Nocatbin/ProjectAir/ProjectAir_PCB/OUTPUT/BOM.xls

Sheet: BOM Report
Bill of Materials |  |  | Bill of Materials for PCB Document [ProjectAir_Pcb.PcbDoc]
Source Data From: |  | ProjectAir_Pcb.PcbDoc
Project: |  | ProjectAir_Pcb.PrjPcb
Variant: |  | None
Creation Date: | 2020/11/1 | 22:56
Print Date: | 2020-11-02 | 19:19:54
Footprint | Comment | LibRef | Designator | Description | Quantity
BAT_RTC | BATT | BAT | BAT1 |  | 1
MAINBAT | MAINBATTARY | MAINBAT | BAT2 | MAINBATTARY | 1
C Pol | Cap Pol3 | Cap Pol3 | C1, C2 | Polarized Capacitor (Surface Mount) | 2
0805 | 104 | C | C3, C4, C5, C7, C12, C13 |  | 6
0805 | 10uF | C, C_2 | C6, C14, C15 |  | 3
0805 | 10 | C | C8, C9 |  | 2
0805 | 22 | C | C10, C11 |  | 2
SOD-123 | 1N4148 | D | D1, D2 |  | 2
0805D | LED BLUE | LED2 | DS1, DS4 | Typical RED, GREEN, YELLOW, AMBER GaAs LED | 2
0805D | LED GREEN | LED2 | DS2 | Typical RED, GREEN, YELLOW, AMBER GaAs LED | 1
0805D | LED RED | LED2 | DS3 | Typical RED, GREEN, YELLOW, AMBER GaAs LED | 1
M2孔 | HOLE | M2孔 | H1, H2, H3, H4 | M2孔 | 4 | /
1*3PIN | 1*3P排针 | 1*3P排针 | J1 | 1*3P排针 | 1
1*4Pin | 1*4P排母 | 1*4P排母 | J2, J3 | 排母 | 2
PWR SWITCH | PWR SWITCH | PWR SWITCH | K1 | PWR SWITCH | 1
0805R | 0R | R | R1, R2 |  | 2
0805R | 10R | R | R3 |  | 1
0805R | 10K | R | R4, R5, R7 |  | 3
0805R | 1M | R | R6 |  | 1
0805R | 1.2K | R_1 | R8 |  | 1
0805R | 1K | R_1 | R9, R10 |  | 2
PTC | PTC 1A | PTC保险 | R11 | PTC 1A | 1
SMD | KEY_M | KEY_M | RESET |  | 1
SOT23-3 | SC662K-3.3V | SC662K-3.3V | U1 | SCK662K-3.3V | 1
STM32F103C8T6 | STM32F103C8T6 | STM32F103C8T6 | U2 | STM32 ARM-based 32-bit MCU with 64 Kbytes Flash, 48-pin LQFP, Industrial Temperature | 1
ESOP-8 | TC4056A | TC4056A | U3 | 充电芯片 | 1
TYPE-C | TYPE-C | TYPE-C | U4 |  | 1
SMD-5032_2P | 8MHz | XTAL | Y1 | Crystal Oscillator | 1
SMD_1610 | 32.768K | XTAL_1 | Y2 | Crystal Oscillator | 1
 |  |  |  |  | 49
Approved |  | Notes

Sheet: Project Information
Project Full Path | C:\Users\15005\Desktop\ProjectAir\ProjectAir_PCB\ProjectAir_Pcb.PrjPcb
Project Filename | ProjectAir_Pcb.PrjPcb
Variant Name | None
Data-Source Filename | ProjectAir_Pcb.PcbDoc
Data-Source Full Path | C:\Users\15005\Desktop\ProjectAir\ProjectAir_PCB\ProjectAir_Pcb.PcbDoc
Title | Bill of Materials for PCB Document [ProjectAir_Pcb.PcbDoc]
Total Quantity | 49
Report Time | 22:56
Report Date | 2020/11/1
Report Date & Tine | 2020/11/1 22:56
Output Name | Bill of Materials
Output Type | BOM_PartType
Output Generator Name | BOM
Output Generator Description | Bill of Materials
