Nocatbin/ProjectAir/ProjectAir_PCB/ProjectAir_Pcb.pdf

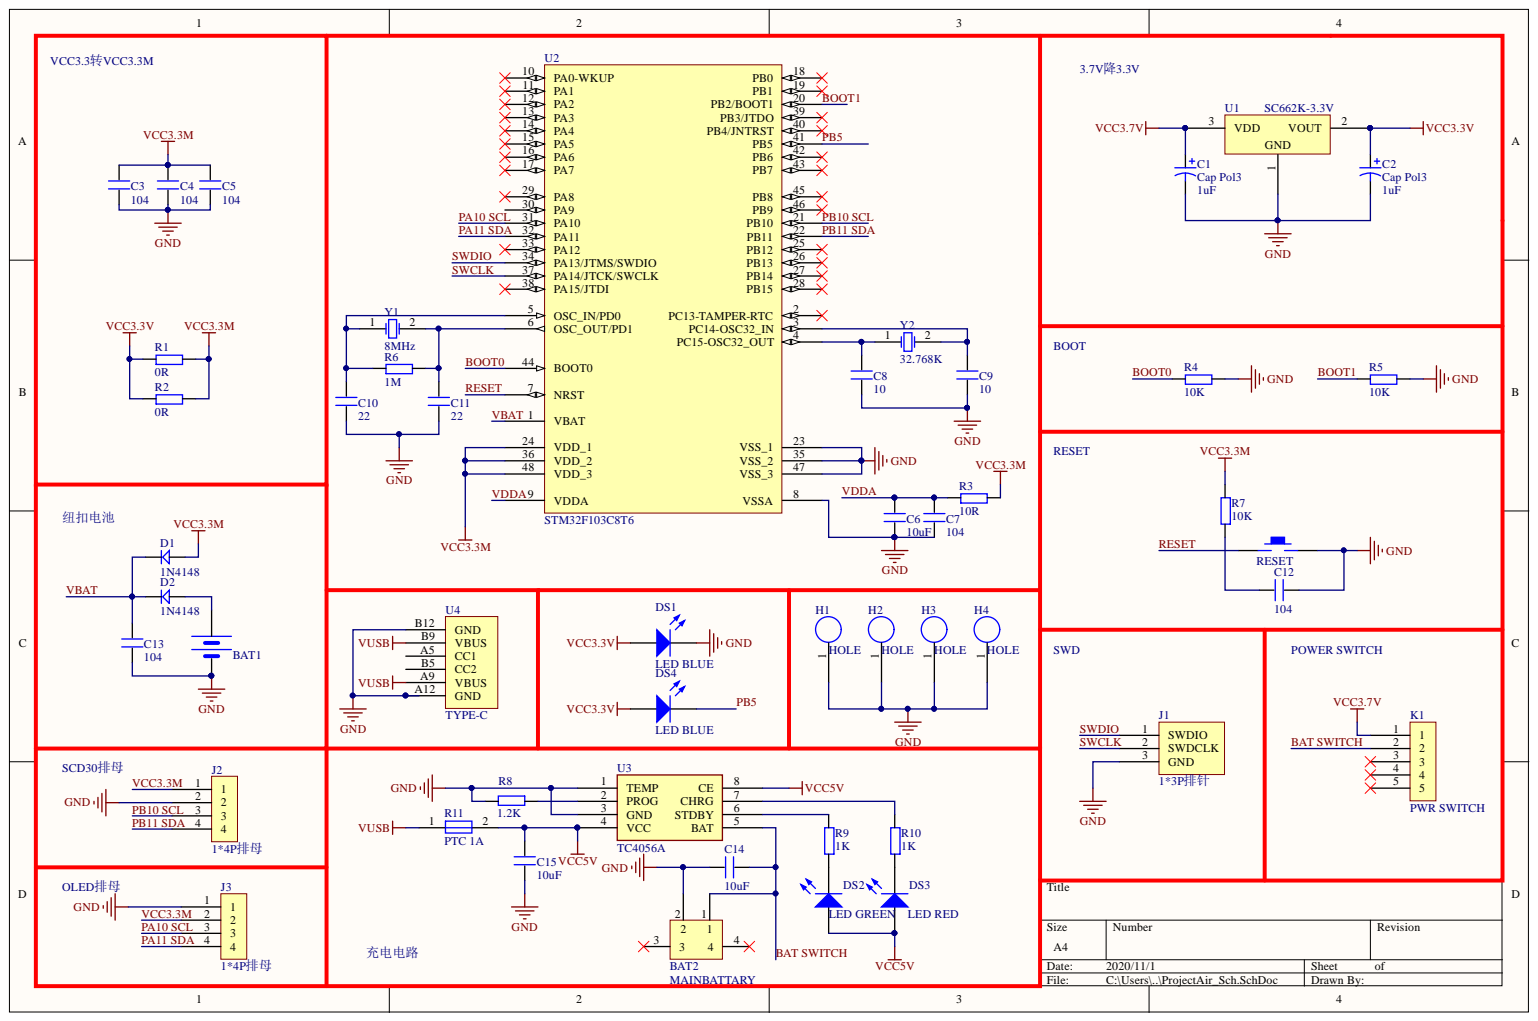
[picture p1: page 1]

VDD_2 36
VDD_3 48

VDDA 9

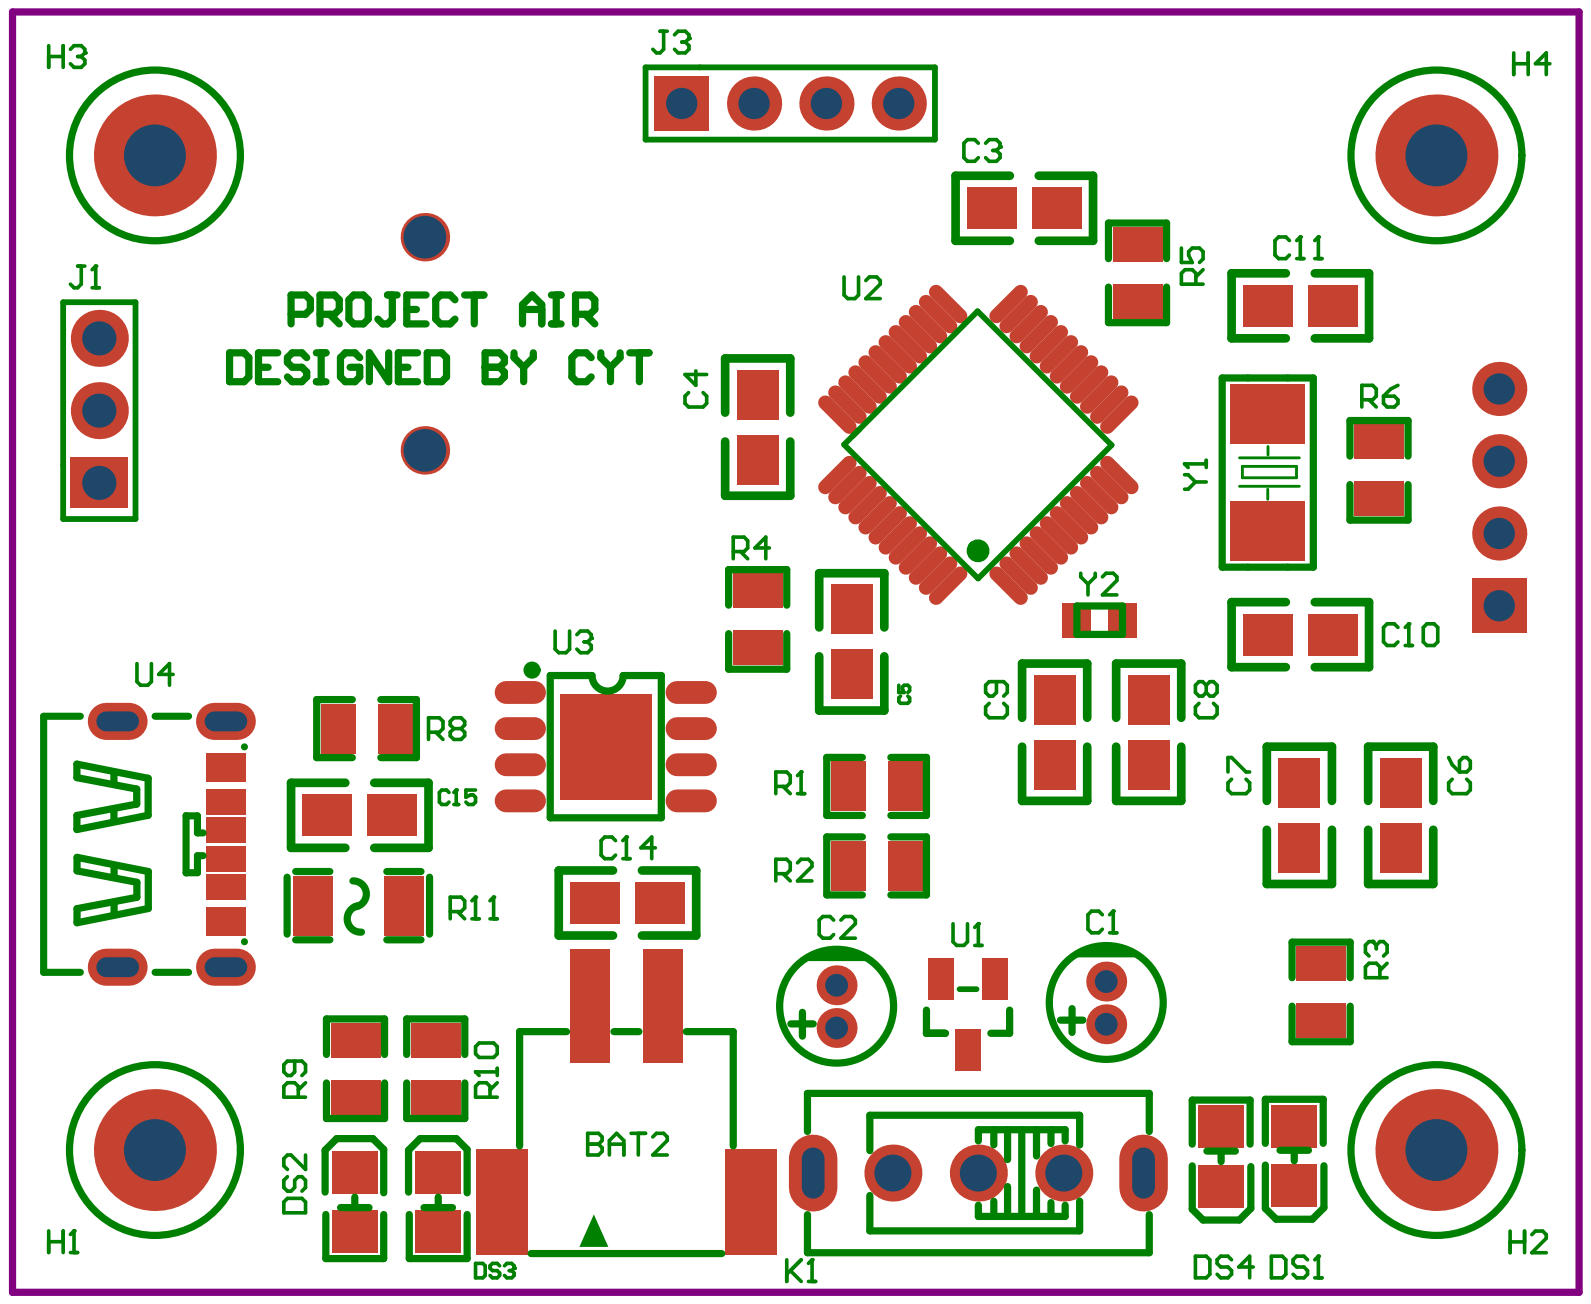
[picture p2: page 2]

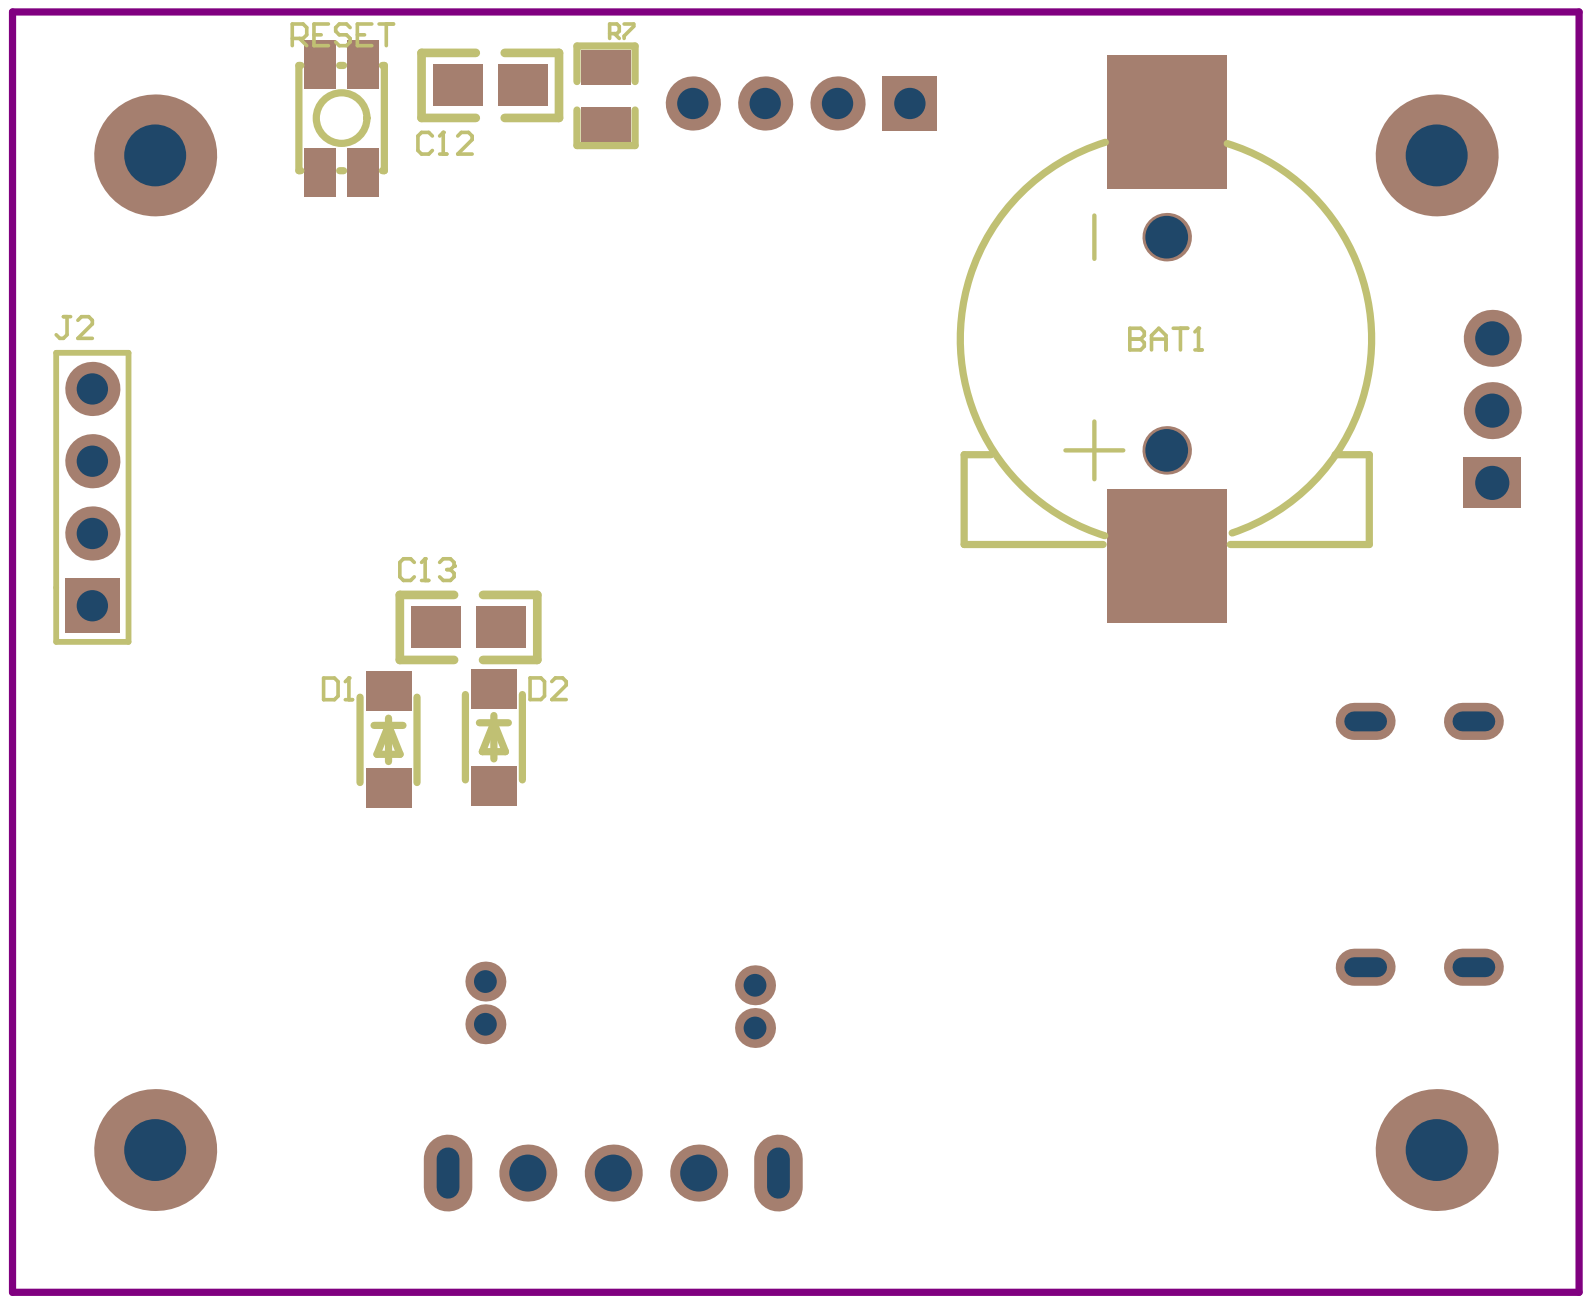
[picture p3: page 3]
