Nocatbin/ProjectAir/(list of files, drawings)

Other design files:
ProjectAir_PCB/ProjectAir_Pcb.PcbDoc
ProjectAir_PCB/ProjectAir_Pcb.PrjPcb
ProjectAir_PCB/ProjectAir_PcbLib.PcbLib
ProjectAir_PCB/ProjectAir_Sch.SchDoc
ProjectAir_PCB/ProjectAir_SchLib.SchLib
