Nocatbin/ProjectAir/USER/main.c

#include "delay.h"
#include "key.h"
#include "sys.h"
#include "usart.h"
#include "I2C.h"
#include "SCD30.h"
#include "rtc.h"
#include "oled.h"

int main(void)
{
	
	delay_init();	    	 //延时函数初始化	  
	NVIC_PriorityGroupConfig(NVIC_PriorityGroup_2); //设置NVIC中断分组2:2位抢占优先级，2位响应优先级
	uart_init(115200);	 //串口初始化
	OLED_Init();			//初始化OLED  
	OLED_Clear();
	RTC_Init();	  			//RTC初始化
	I2C_congfig();
	I2C_StretchClockCmd(I2C2, ENABLE);
	SCD30_TriggerContinuousMeasurement();
	delay_ms(3);
	while(1);
}
