Nocatbin/ProjectAir/HARDWARE/SCD30/SCD30.c

#include "stm32f10x.h"
#include "I2C.h"
#include "SCD30.h"
#include "sys.h" 
#include "delay.h"
#include "usart.h"


uint8_t sensirion_common_generate_crc(const uint8_t* data, uint16_t count)
{
    uint16_t current_byte;
    uint8_t crc = CRC8_INIT;
    uint8_t crc_bit;

    /* calculates 8-Bit checksum with given polynomial */
    for (current_byte = 0; current_byte < count; ++current_byte) {
        crc ^= (data[current_byte]);
        for (crc_bit = 8; crc_bit > 0; --crc_bit) {
            if (crc & 0x80)
                crc = (crc << 1) ^ CRC8_POLYNOMIAL;
            else
                crc = (crc << 1);
        }
    }
    return crc;
}

int8_t sensirion_common_check_crc(const uint8_t* data, uint16_t count,uint8_t checksum)
{
    if (sensirion_common_generate_crc(data, count) != checksum)
        return STATUS_FAIL;
    return NO_ERROR;
}

float bytes_to_float(u8 MMSB, u8 MLSB, u8 LMSB, u8 LLSB)
{
    union
		{
        uint32_t u32_value;
        float float32;
    } tmp;

    tmp.u32_value = bytes_to_uint32_t(MMSB, MLSB, LMSB, LLSB);
    return tmp.float32;
}

u32 bytes_to_uint32_t(u8 MMSB, u8 MLSB, u8 LMSB, u8 LLSB)
{
	
	return (u32)MMSB << 24 | (u32)MLSB << 16 |
           (u32)LMSB << 8 | (u32)LLSB;
}



//读取SCD30测量的数据 包含CRC位 共9个字节
//Param
//*data 读取出的数据首地址 可为数组
void SCD30_ReadMeasurement(u8 *data)
{
	u32 i = 0, j = 0;
	//生成Start信号
	I2C_GenerateSTART(I2C_Num, ENABLE);
	//检测EV5事件
	while(I2C_CheckEvent(I2C_Num, I2C_EVENT_MASTER_MODE_SELECT) == ERROR)
	{
		i++;
		if(i>=10000)
		{
			printf("error2-1\n");
			break;
		}
	}
	
	i = 0;
	//发送设备地址 写模式
	I2C_Send7bitAddress(I2C_Num, TargetAddress, I2C_Direction_Transmitter);
	//检测EV6事件
	while(I2C_CheckEvent(I2C_Num, I2C_EVENT_MASTER_TRANSMITTER_MODE_SELECTED) == ERROR)
	{
		i++;
		if(i>=1000)
		{
			printf("error2-2\n");
			break;
		}
	}
	
	i = 0;
	//发送数据,即读数据的内存地址MSB 0x03
	I2C_SendData(I2C_Num, 0x03);
	//检测EV8事件
	while(I2C_CheckEvent(I2C_Num, I2C_EVENT_MASTER_BYTE_TRANSMITTING) == ERROR)
	{
		i++;
		if(i>=100)
		{
			printf("error2-3\n");
			break;
		}
	}
	
	i = 0;
	delay_ms(1);
	//发送数据,即读数据的内存地址LSB 0x00
	I2C_SendData(I2C_Num, 0x00);
	//检测EV8_2事件
	while(I2C_CheckEvent(I2C_Num, I2C_EVENT_MASTER_BYTE_TRANSMITTED) == ERROR)
	{
		i++;
		if(i>=10000)
		{
			printf("error2-4\n");
			break;
		}
	}
	
	i = 0;
	//生成Stop信号
	I2C_GenerateSTOP(I2C_Num, ENABLE);
	//写过程结束  准备开始读数据
	
	//延迟3ms以上
	delay_ms(5);
	
	//读数据过程开始
	//再次生成Start信号
	I2C_GenerateSTART(I2C_Num, ENABLE);
	//检测EV5事件
	while(I2C_CheckEvent(I2C_Num, I2C_EVENT_MASTER_MODE_SELECT) == ERROR)
	{
		i++;
		if(i>=10000)
		{
			printf("error2-5\n");
			break;
		}
	}
	
	i = 0;
	//发送设备地址 读模式
	I2C_Send7bitAddress(I2C_Num, TargetAddress, I2C_Direction_Receiver);
	//检测EV6事件
	while(I2C_CheckEvent(I2C_Num, I2C_EVENT_MASTER_RECEIVER_MODE_SELECTED) == ERROR)
	{
		i++;
		if(i>=10000)
		{
			printf("error2-6\n");
			break;
		}
	}
	
	i = 0;
	//开始读数据
	for(j = 0; j < 18; j++)
	{
		if(j == 17)
		{
			//准备读最后一个字节 发送NACK
			I2C_AcknowledgeConfig(I2C_Num, DISABLE);
		}
		//检测EV7事件
		while(I2C_CheckEvent(I2C_Num, I2C_EVENT_MASTER_BYTE_RECEIVED) == ERROR)
		{
			i++;
			if(i>=10000)
			{
				printf("error2-7\n");
				break;
			}
		}
		i = 0;
		//读一个字节数据 
		*data = I2C_ReceiveData(I2C_Num);
		data++;
	}
	
	//重新打开自动ACK
	I2C_AcknowledgeConfig(I2C_Num, ENABLE);
	
	//数据传输完成 生成Stop信号
	I2C_GenerateSTOP(I2C_Num, ENABLE);
}



//打开SCD30的连续采集数据模式
void SCD30_TriggerContinuousMeasurement(void)
{
	u32 i = 0;
	I2C_GenerateSTART(I2C_Num, ENABLE);
	//检测EV5事件
	while(I2C_CheckEvent(I2C_Num, I2C_EVENT_MASTER_MODE_SELECT) == ERROR)
	{
		i++;
		if(i>=100000)
		{
			printf("error1-1\n");
			break;
		}
	}
	
	i = 0;
	I2C_Send7bitAddress(I2C_Num, TargetAddress, I2C_Direction_Transmitter);
	//检测EV6事件
	while(I2C_CheckEvent(I2C_Num, I2C_EVENT_MASTER_TRANSMITTER_MODE_SELECTED) == ERROR)
	{
		i++;
		if(i>=100000)
		{
			printf("error1-2\n");
			break;
		}
	}
	
	i = 0;
	//以下发送16bit CMD
	I2C_SendData(I2C_Num, 0x00);
	//检测EV8事件
	while(I2C_CheckEvent(I2C_Num, I2C_EVENT_MASTER_BYTE_TRANSMITTING) == ERROR)
	{
		i++;
		if(i>=100)
		{
			printf("error1-3\n");
			break;
		}
	}
	i = 0;
	delay_ms(1);
	I2C_SendData(I2C_Num, 0x10);
	//检测EV8事件
	while(I2C_CheckEvent(I2C_Num, I2C_EVENT_MASTER_BYTE_TRANSMITTING) == ERROR)
	{
		i++;
		if(i>=100)
		{
			printf("error1-4\n");
			break;
		}
	}
	
	i = 0;
	delay_ms(1);
	//以下发送16bit Pressure
	I2C_SendData(I2C_Num, 0x00);
	//检测EV8事件
	while(I2C_CheckEvent(I2C_Num, I2C_EVENT_MASTER_BYTE_TRANSMITTING) == ERROR)
	{
		i++;
		if(i>=100)
		{
			printf("error1-5\n");
			break;
		}
	}
	
	i = 0;
	delay_ms(1);
	I2C_SendData(I2C_Num, 0x00);
	//检测EV8事件
	while(I2C_CheckEvent(I2C_Num, I2C_EVENT_MASTER_BYTE_TRANSMITTING) == ERROR)
	{
		i++;
		if(i>=100)
		{
			printf("error1-6\n");
			break;
		}
	}
	
	i = 0;
	delay_ms(1);
	//发送CRC
	I2C_SendData(I2C_Num, 0x81);
	//检测EV8_2事件
	while(I2C_CheckEvent(I2C_Num, I2C_EVENT_MASTER_BYTE_TRANSMITTED) == ERROR)
	{
		i++;	
		if(i>=100000)
		{
			printf("error1-7\n");
			break;
		}
	}
	
	//数据传输完成 生成Stop信号
	I2C_GenerateSTOP(I2C_Num, ENABLE);
}


u8 SCD30_CheckDataReady(void)
{
	u8 DataReadyMSB, DataReadyLSB;
	u32 i=0;
	//生成Start信号
	I2C_GenerateSTART(I2C_Num, ENABLE);
	//检测EV5事件
	while(I2C_CheckEvent(I2C_Num, I2C_EVENT_MASTER_MODE_SELECT) == ERROR)
	{
		i++;
		if(i>=100000)
		{
			printf("error8\n");
			break;
		}
	}
	
	i=0;
	delay_ms(1);
	//发送设备地址 写模式
	I2C_Send7bitAddress(I2C_Num, TargetAddress, I2C_Direction_Transmitter);
	//检测EV6事件
	while(I2C_CheckEvent(I2C_Num, I2C_EVENT_MASTER_TRANSMITTER_MODE_SELECTED) == ERROR)
	{
		i++;
		if(i>=10000)
		{
			printf("error9\n");
			break;
		}
	}
	
	i = 0;
	//发送数据,即读数据的内存地址MSB 0x02
	I2C_SendData(I2C_Num, 0x02);
	//检测EV8事件
	while(I2C_CheckEvent(I2C_Num, I2C_EVENT_MASTER_BYTE_TRANSMITTING) == ERROR)
	{
		i++;
		if(i>=1000)
		{
			printf("error10\n");
			break;
		}
	}
	
	i = 0;
	delay_ms(1);
	//发送数据,即读数据的内存地址LSB 0x02
	I2C_SendData(I2C_Num, 0x02);
	//检测EV8_2事件
	while(I2C_CheckEvent(I2C_Num, I2C_EVENT_MASTER_BYTE_TRANSMITTED) == ERROR)
	{
		i++;
		if(i>=10000)
		{
			printf("error11\n");
			break;
		}
	}
	
	i = 0;
	//生成Stop信号
	I2C_GenerateSTOP(I2C_Num, ENABLE);
	//写过程结束  准备开始读数据
	
	//延迟3ms以上
	delay_ms(5);
	
	//读数据过程开始
	//再次生成Start信号
	I2C_GenerateSTART(I2C_Num, ENABLE);
	//检测EV5事件
	while(I2C_CheckEvent(I2C_Num, I2C_EVENT_MASTER_MODE_SELECT) == ERROR)
	{
		i++;
		if(i>=10000)
		{
			printf("error12\n");
			break;
		}
	}
	
	i = 0;
	//发送设备地址 读模式
	I2C_Send7bitAddress(I2C_Num, TargetAddress, I2C_Direction_Receiver);
	//检测EV6事件
	while(I2C_CheckEvent(I2C_Num, I2C_EVENT_MASTER_RECEIVER_MODE_SELECTED) == ERROR)
	{
		i++;
		if(i>=10000)
		{
			printf("error13\n");
			break;
		}
	}
	
	i = 0;
	//开始读数据
	while(I2C_CheckEvent(I2C_Num, I2C_EVENT_MASTER_BYTE_RECEIVED) == ERROR)
	{
		i++;
		if(i>=10000)
		{
			printf("error14\n");
			break;
		}
	}
	
	i = 0;
	//读一个字节数据 
	DataReadyMSB = I2C_ReceiveData(I2C_Num);
	
	//准备读最后一个字节 发送NACK
	I2C_AcknowledgeConfig(I2C_Num, DISABLE);
	
	while(I2C_CheckEvent(I2C_Num, I2C_EVENT_MASTER_BYTE_RECEIVED) == ERROR)
	{
		i++;
		if(i>=10000)
		{
			printf("error14\n");
			break;
		}
	}
	DataReadyLSB = I2C_ReceiveData(I2C_Num);
	
	//重新打开自动ACK
	I2C_AcknowledgeConfig(I2C_Num, ENABLE);
	
	//数据传输完成 生成Stop信号
	I2C_GenerateSTOP(I2C_Num, ENABLE);

	if(DataReadyMSB == 0x00 && DataReadyLSB == 0x01)
		return 0x01;
	else
		return 0x00;
}
