Nocatbin/ProjectAir/(commit log)

2020-07-23 首次提交PROJECT
2020-07-23 新增触发连续采集模式及读取SCD30数据函数，存在BUG
2020-07-23 改了个寂寞
2020-07-26 修复了 激活连续采集模式的bug
2020-07-27 出现莫名其妙BUG， 连续采集数据模式出错
2020-07-27 DEBUG了个寂寞
2020-09-14 完成SCD30传感器连续采集并串口打印
2020-09-20 增加了TFTLCD显示模块
2020-09-20 修改了一行字符串长度
2020-09-20 补充提交LCD库
2020-09-20 修改了count的显示位数
2020-09-24 增加了原理图
    [ProjectAir_Pcb.PcbDoc, ProjectAir_Pcb.PrjPcb, ProjectAir_PcbLib.PcbLib, ProjectAir_Sch.SchDoc, ProjectAir_SchLib.SchLib]
2020-09-24 加了几根边框线
    [ProjectAir_Sch.SchDoc]
2020-09-25 增加了充电电路喝LDO稳压电路
    [ProjectAir_PcbLib.PcbLib, ProjectAir_Sch.SchDoc, ProjectAir_SchLib.SchLib]
2020-09-25 增加了24P FPC抽屉式母座
    [ProjectAir_Sch.SchDoc, ProjectAir_SchLib.SchLib]
2020-09-26 不知道为啥又要提交了
2020-09-27 添加了墨水屏显示库 但是局部刷新没调试
2020-09-28 融合了一部分墨水屏的代码
2020-09-30 加了一堆注释 完成partial display
2020-10-01 调试Partial Display，尝试自己添加字库
2020-10-02 完成了FPC排座的电路
    [GDE_Driver.SchDoc, ProjectAir_Pcb.PrjPcb, ProjectAir_Sch.SchDoc]
2020-10-02 新增了数字字库，字体大小不合适，有待修改；新增RTC库
    [GDE_Driver.SchDoc, ProjectAir_SchLib.SchLib]
2020-10-03 修改了一下RTC库中的部分函数，还需要将墨水屏驱动改一改
2020-10-04 继续修改屏幕驱动
2020-10-04 准备弃用墨水屏，上传备份一波。
2020-10-05 再次尝试局部刷新的效果 依然很差，同时对比了微雪给的例程 无效
2020-10-05 再次尝试墨水屏局刷失败
2020-10-05 粗略完成OLED显示功能，还需要增加显示位置的移动防止烧屏
2020-10-06 加了OLED排针，需添加USB母座
    [GDE_Driver.SchDoc, ProjectAir_Pcb.PrjPcb, ProjectAir_Sch.SchDoc, ProjectAir_SchLib.SchLib]
2020-10-07 稍微改了点电路，缺了boot，usb和reset电路
    [ProjectAir_Sch.SchDoc]
2020-10-10 画板子中 原理图基本结束
    [ProjectAir_Pcb.PrjPcb, ProjectAir_Sch.SchDoc, ProjectAir_SchLib.SchLib]
2020-10-11 缺usb电路
    [ProjectAir_PcbLib.PcbLib, ProjectAir_Sch.SchDoc, ProjectAir_SchLib.SchLib]
2020-10-17 加了个TYPEC
    [ProjectAir_PcbLib.PcbLib, ProjectAir_Sch.SchDoc, ProjectAir_SchLib.SchLib]
2020-10-17 终于完成了原理图绘制，准备开始PCB LAYOUT
    [ProjectAir_Pcb.PcbDoc, ProjectAir_Pcb.PrjPcb, ProjectAir_PcbLib.PcbLib, ProjectAir_Sch.SchDoc, ProjectAir_SchLib.SchLib]
2020-10-18 PCB布局进行中
    [ProjectAir_Pcb.PcbDoc, ProjectAir_PcbLib.PcbLib, ProjectAir_Sch.SchDoc, ProjectAir_SchLib.SchLib]
2020-10-23 没干什么
    [ProjectAir_Pcb.PcbDoc]
2020-10-26 reset电路还要改
    [ProjectAir_Pcb.PcbDoc, ProjectAir_Sch.SchDoc]
2020-10-26 器件排列完毕，等待走线
    [ProjectAir_Pcb.PcbDoc, ProjectAir_PcbLib.PcbLib, ProjectAir_SchLib.SchLib]
2020-10-26 开始布线
    [ProjectAir_Pcb.PcbDoc]
2020-10-27 布线ing
    [ProjectAir_Pcb.PcbDoc, ProjectAir_PcbLib.PcbLib, ProjectAir_Sch.SchDoc]
2020-10-27 随便铺了铺铜
    [ProjectAir_Pcb.PcbDoc]
2020-10-28 布线还没完成，仍需优化
    [ProjectAir_Pcb.PcbDoc]
2020-10-29 随便改了一点
    [ProjectAir_Pcb.PcbDoc]
2020-11-01 初步完成连线
    [ProjectAir_Pcb.PcbDoc]
2020-11-01 完成了走线与铺铜
    [ProjectAir_Pcb.PcbDoc]
2020-11-01 已生成gerber文件打样，待测试
    [BOM.xls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]
2020-11-01 已经提交订单，等待审核
    [ProjectAir_Pcb.PrjPcb]
2020-11-02 PCB开始制作。核对BOM表采购元件中
    [BOM.xls]
2020-11-02 BOM表核对完成，已下单
    [BOM.xls]
2020-11-05 整理文件
