Nocatbin/ProjectAir/(notices)

Notices in the files:
SYSTEM/usart/usart.c:
Copyright(C) ¹ãÖÝÊÐÐÇÒíµç×Ó¿Æ¼¼ÓÐÏÞ¹«Ë¾ 2009-2019
All rights reserved
HARDWARE/OLED/oled.h:
Copyright(C) ÖÐ¾°Ô°µç×Ó2014/3/16
